zhuwenguan/2025NUEDC_A_Project/README.md

# 2025NUEDC_A_Project

## 简介
本仓库是2025年全国大学生电子竞赛A题——能量回馈的变流器负载试验装置的方案。实现了赛题要求的全部功能，达成了赛题要求的全部指标。

## 构造
1. Hardware文件夹
   包含该项目的所有硬件资料。基于嘉立创EDA设计。
2. Firmware文件夹
   包含该项目的STM32固件源代码。使用STM32CubeMX软件配合Keil MDK-ARM开发。
3. Docs文件夹
   包含该项目的说明文档和博客。

## 方案解析
请参阅[我的博客](https://zhuwenguan.github.io/blog/2025/08/08/25%E7%94%B5%E8%B5%9BA%E9%A2%98%E6%BB%A1%E5%88%86%E6%96%B9%E6%A1%88%E8%A7%A3%E6%9E%90/)
