zhuwenguan/2025NUEDC_A_Project/(list of files, drawings)

Other design files:
1.Hardware/2025NUEDC_A_Project.eprj
