zhuwenguan/2025NUEDC_A_Project/2.Firmware/Core/Src/main.c

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
/* Includes ------------------------------------------------------------------*/
#include "main.h"
#include "adc.h"
#include "dma.h"
#include "ltdc.h"
#include "spi.h"
#include "tim.h"
#include "gpio.h"

/* USER CODE BEGIN Includes */

#include "spwm.h"
#include "volt.h"
#include "curr.h"
#include "ili9341.h"
#include "lcd.h"
#include "stm32f429i_discovery_lcd.h"
#include <string.h>
#include <stdio.h>

/* USER CODE END Includes */


/* USER CODE BEGIN PV */

uint8_t updateFlag;
SPWM_HandleTypeDef hspwm_u, hspwm_v, hspwm_w;
uint16_t volt_buffer[1000];
uint16_t curr_buffer[1000];

uint16_t frameBuffer[240*160];

float rms;
float output = 1.0f;
float target = 32.0f;
float curr_target = 1.0f;
uint32_t freq = 50;
float curr;
float output_curr = 0.15f;

/* USER CODE END PV */

void SystemClock_Config(void);
/* USER CODE BEGIN 0 */

void KeyScan()
{
	static uint32_t lastTime, addTime;
	static uint32_t cnt = 0;
	static uint32_t longPress;
	if(HAL_GetTick() - lastTime >= 10)
	{
		lastTime = HAL_GetTick();
		if(HAL_GPIO_ReadPin(GPIOA, GPIO_PIN_0) == GPIO_PIN_SET)
		{
			if(cnt < 2)
			{
				cnt++;
			}
			if(cnt == 2)
			{
				longPress++;
				if(longPress >= 200)
				{
					if(HAL_GetTick() - addTime >= 100)
					{
						addTime = HAL_GetTick();
						if(freq < 150)
							freq++;
					}
				}
			}
		}
		else
		{
			if(cnt == 2)
			{
				cnt = 3;
				freq++;
				if(freq > 150)
					freq = 20;
			}
			else
			{
				cnt = 0;
				longPress = 0;
			}
		}
	}
}

void LCD_Init()
{
	ili9341_Init();
	BSP_LCD_SetTextColor(0xFFFF);
	BSP_LCD_SetFont(&Font12);
}

void LCD_Refresh()
{
	static uint32_t lastTime;
	if(HAL_GetTick() - lastTime < 200)
		return;
	
	lastTime = HAL_GetTick();
	char str[64];
	snprintf(str, 64, "Volt: %.2f", rms);
	BSP_LCD_DisplayStringAt(0, 0, (uint8_t*)str, LEFT_MODE);
//	snprintf(str, 64, "Current: %.2f", curr);
//	BSP_LCD_DisplayStringAt(0, 14, (uint8_t*)str, LEFT_MODE);
	snprintf(str, 64, "Freq: %d Hz", freq);
	BSP_LCD_DisplayStringAt(0, 14, (uint8_t*)str, LEFT_MODE);
//	snprintf(str, 64, "SPWM Rate: %.2f", output);
//	BSP_LCD_DisplayStringAt(0, 42, (uint8_t*)str, LEFT_MODE);
//	snprintf(str, 64, "BOOST Duty: %.2f", output_curr);
//	BSP_LCD_DisplayStringAt(0, 56, (uint8_t*)str, LEFT_MODE);
}

/* USER CODE END 0 */

/**
  * @brief  The application entry point.
  * @retval int
  */
int main(void)
{

  /* MCU Configuration--------------------------------------------------------*/

  /* Reset of all peripherals, Initializes the Flash interface and the Systick. */
  HAL_Init();

  /* Configure the system clock */
  SystemClock_Config();

  /* Initialize all configured peripherals */
  MX_GPIO_Init();
  MX_DMA_Init();
  MX_TIM1_Init();
  MX_TIM8_Init();
  MX_ADC1_Init();
  MX_TIM2_Init();
  MX_ADC2_Init();
  MX_LTDC_Init();
  MX_SPI5_Init();
  /* USER CODE BEGIN 2 */
  SPWM_Init(&hspwm_u, PWM_MAX, freq, 0.0f);
  SPWM_Init(&hspwm_v, PWM_MAX, freq, 0.3333333f);
  SPWM_Init(&hspwm_w, PWM_MAX, freq, 0.6666666f);
  
  HAL_TIM_Base_Start(&htim8);
  __HAL_TIM_SetCompare(&htim8, TIM_CHANNEL_3, TIM8->ARR+1);
  HAL_TIM_PWM_Start(&htim8, TIM_CHANNEL_3);
  
  HAL_TIM_Base_Start(&htim1);
  HAL_TIM_PWM_Start_DMA(&htim1, TIM_CHANNEL_1, (uint32_t*)hspwm_u.array, hspwm_u.size);
  HAL_TIM_PWM_Start_DMA(&htim1, TIM_CHANNEL_2, (uint32_t*)hspwm_v.array, hspwm_v.size);
  HAL_TIM_PWM_Start_DMA(&htim1, TIM_CHANNEL_3, (uint32_t*)hspwm_w.array, hspwm_w.size);
  
  HAL_TIM_Base_Start(&htim2);
  HAL_ADC_Start_DMA(&hadc1, (uint32_t*)volt_buffer, 1000);
  HAL_ADC_Start_DMA(&hadc2, (uint32_t*)curr_buffer, 1000);
  
  LCD_Init();
  VOLT_Init();
  CURR_Init();
  /* USER CODE END 2 */

  /* Infinite loop */
  /* USER CODE BEGIN WHILE */
  while (1)
  {
    /* USER CODE END WHILE */

    /* USER CODE BEGIN 3 */
	  VOLT_Update();
	  CURR_Update();
	  SPWM_Update();
	  LCD_Refresh();
	  KeyScan();
  }
  /* USER CODE END 3 */
}

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
