zhuwenguan/2025NUEDC_A_Project/2.Firmware/2025NUEDC_A_Project.ioc

Mcu.UserName=STM32F429ZITx
PA0/WKUP.Signal=GPIO_Input
PA11.Signal=LTDC_R4
PA12.Signal=LTDC_R5
PA13.Signal=SYS_JTMS-SWDIO
PA14.Signal=SYS_JTCK-SWCLK
PA3.Signal=LTDC_B5
PA4.Signal=LTDC_VSYNC
PA6.Signal=LTDC_G2
PB0.Signal=LTDC_R3
PB1.Signal=LTDC_R6
PB10.Signal=LTDC_G4
PB11.Signal=LTDC_G5
PB12.Signal=GPIO_Output
PB8.Signal=LTDC_B6
PB9.Signal=LTDC_B7
PC2.GPIO_Label=LCD_NCS
PC2.Signal=GPIO_Output
PC4.Signal=ADCx_IN14
PC5.Signal=ADCx_IN15
PC6.Signal=LTDC_HSYNC
PC7.Signal=LTDC_G6
PC8.Signal=S_TIM8_CH3
PD12.GPIO_Label=LCD_RDX
PD12.Signal=GPIO_Output
PD13.GPIO_Label=LCD_WRX
PD13.Signal=GPIO_Output
PD3.Signal=LTDC_G7
PE11.Signal=S_TIM1_CH2
PE13.Signal=S_TIM1_CH3
PE15.Signal=GPIO_Output
PE9.Signal=S_TIM1_CH1
PF10.Signal=LTDC_DE
PF7.Signal=SPI5_SCK
PF8.Signal=SPI5_MISO
PF9.Signal=SPI5_MOSI
PG10.Signal=LTDC_G3
PG11.Signal=LTDC_B3
PG12.Signal=LTDC_B4
PG5.Signal=GPIO_Output
PG6.Signal=LTDC_R7
PG7.Signal=LTDC_CLK
PH0/OSC_IN.Signal=RCC_OSC_IN
PH1/OSC_OUT.Signal=RCC_OSC_OUT
