zhuwenguan/2025NUEDC_A_Project/2.Firmware/Core/Inc/main.h

#define PWM_FREQ (80000)
#define PWM_MAX (2250-1)
#define LCD_NCS_Pin GPIO_PIN_2
#define LCD_NCS_GPIO_Port GPIOC
#define LCD_RDX_Pin GPIO_PIN_12
#define LCD_RDX_GPIO_Port GPIOD
#define LCD_WRX_Pin GPIO_PIN_13
#define LCD_WRX_GPIO_Port GPIOD
