zhuwenguan/2025NUEDC_A_Project/2.Firmware/Core/Src/ili9341.c

/**
  ******************************************************************************
  * @file    ili9341.c
  * @author  MCD Application Team
  * @version V1.0.2
  * @date    02-December-2014
  * @brief   This file includes the LCD driver for ILI9341 LCD.
  ******************************************************************************
  * @attention
  *
  * Copyright (c) 2014 STMicroelectronics.
  * All rights reserved.
  *
  * This software is licensed under terms that can be found in the LICENSE file
  * in the root directory of this software component.
  * If no LICENSE file comes with this software, it is provided AS-IS.
  *
  ******************************************************************************
  */ 

/* Includes ------------------------------------------------------------------*/
#include "ili9341.h"
#include "main.h"
#include "spi.h"
/** @addtogroup BSP
  * @{
  */ 

/** @addtogroup Components
  * @{
  */ 
  
/** @addtogroup ILI9341
  * @brief This file provides a set of functions needed to drive the 
  *        ILI9341 LCD.
  * @{
  */

/** @defgroup ILI9341_Private_TypesDefinitions
  * @{
  */ 
/**
  * @}
  */ 

/** @defgroup ILI9341_Private_Defines
  * @{
  */
/**
  * @}
  */ 
  
/** @defgroup ILI9341_Private_Macros
  * @{
  */
/**
  * @}
  */  

/** @defgroup ILI9341_Private_Variables
  * @{
  */ 

LCD_DrvTypeDef   ili9341_drv = 
{
  ili9341_Init,
  ili9341_ReadID,
  ili9341_DisplayOn,
  ili9341_DisplayOff,
  0,
  0,
  0,
  0,
  0,
  0,
  ili9341_GetLcdPixelWidth,
  ili9341_GetLcdPixelHeight,
  0,
  0,    
};

/**
  * @}
  */ 
  
/** @defgroup ILI9341_Private_FunctionPrototypes
  * @{
  */

/**
  * @}
  */ 
  
/** @defgroup ILI9341_Private_Functions
  * @{
  */   

/* Chip Select macro definition */
#define LCD_CS_LOW()       HAL_GPIO_WritePin(LCD_NCS_GPIO_PORT, LCD_NCS_PIN, GPIO_PIN_RESET)
#define LCD_CS_HIGH()      HAL_GPIO_WritePin(LCD_NCS_GPIO_PORT, LCD_NCS_PIN, GPIO_PIN_SET)

/* Set WRX High to send data */
#define LCD_WRX_LOW()      HAL_GPIO_WritePin(LCD_WRX_GPIO_PORT, LCD_WRX_PIN, GPIO_PIN_RESET)
#define LCD_WRX_HIGH()     HAL_GPIO_WritePin(LCD_WRX_GPIO_PORT, LCD_WRX_PIN, GPIO_PIN_SET)

/* Set WRX High to send data */
#define LCD_RDX_LOW()      HAL_GPIO_WritePin(LCD_RDX_GPIO_PORT, LCD_RDX_PIN, GPIO_PIN_RESET)
#define LCD_RDX_HIGH()     HAL_GPIO_WritePin(LCD_RDX_GPIO_PORT, LCD_RDX_PIN, GPIO_PIN_SET)

/**
  * @brief  LCD Control pin
  */
#define LCD_NCS_PIN                             GPIO_PIN_2
#define LCD_NCS_GPIO_PORT                       GPIOC
#define LCD_NCS_GPIO_CLK_ENABLE()               __HAL_RCC_GPIOC_CLK_ENABLE()
#define LCD_NCS_GPIO_CLK_DISABLE()              __HAL_RCC_GPIOC_CLK_DISABLE()
/**
  * @}
  */
/**
  * @brief  LCD Command/data pin
  */
#define LCD_WRX_PIN                             GPIO_PIN_13
#define LCD_WRX_GPIO_PORT                       GPIOD
#define LCD_WRX_GPIO_CLK_ENABLE()               __HAL_RCC_GPIOD_CLK_ENABLE()
#define LCD_WRX_GPIO_CLK_DISABLE()              __HAL_RCC_GPIOD_CLK_DISABLE()

#define LCD_RDX_PIN                             GPIO_PIN_12
#define LCD_RDX_GPIO_PORT                       GPIOD
#define LCD_RDX_GPIO_CLK_ENABLE()               __HAL_RCC_GPIOD_CLK_ENABLE()
#define LCD_RDX_GPIO_CLK_DISABLE()              __HAL_RCC_GPIOD_CLK_DISABLE()

/**
  * @brief  Reads 4 bytes from device.
  * @param  ReadSize: Number of bytes to read (max 4 bytes)
  * @retval Value read on the SPI
  */
static uint32_t SPIx_Read(uint8_t ReadSize)
{
  HAL_StatusTypeDef status = HAL_OK;
  uint32_t readvalue;

  status = HAL_SPI_Receive(&hspi5, (uint8_t *) &readvalue, ReadSize, 0x1000);

  /* Check the communication status */
  if (status != HAL_OK)
  {
    /* Re-Initialize the BUS */
    Error_Handler();
  }

  return readvalue;
}

/**
  * @brief  Writes a byte to device.
  * @param  Value: value to be written
  */
static void SPIx_Write(uint16_t Value)
{
  HAL_StatusTypeDef status = HAL_OK;

  status = HAL_SPI_Transmit(&hspi5, (uint8_t *) &Value, 1, 0x1000);

  /* Check the communication status */
  if (status != HAL_OK)
  {
    /* Re-Initialize the BUS */
    Error_Handler();
  }
}

/**
  * @brief  Writes register value.
  */
void LCD_IO_WriteData(uint16_t RegValue)
{
  /* Set WRX to send data */
  LCD_WRX_HIGH();

  /* Reset LCD control line(/CS) and Send data */
  LCD_CS_LOW();
  SPIx_Write(RegValue);

  /* Deselect: Chip Select high */
  LCD_CS_HIGH();
}

/**
  * @brief  Writes register address.
  */
void LCD_IO_WriteReg(uint8_t Reg)
{
  /* Reset WRX to send command */
  LCD_WRX_LOW();

  /* Reset LCD control line(/CS) and Send command */
  LCD_CS_LOW();
  SPIx_Write(Reg);

  /* Deselect: Chip Select high */
  LCD_CS_HIGH();
}

/**
  * @brief  Reads register value.
  * @param  RegValue Address of the register to read
  * @param  ReadSize Number of bytes to read
  * @retval Content of the register value
  */
uint32_t LCD_IO_ReadData(uint16_t RegValue, uint8_t ReadSize)
{
  uint32_t readvalue = 0;

  /* Select: Chip Select low */
  LCD_CS_LOW();

  /* Reset WRX to send command */
  LCD_WRX_LOW();

  SPIx_Write(RegValue);

  readvalue = SPIx_Read(ReadSize);

  /* Set WRX to send data */
  LCD_WRX_HIGH();

  /* Deselect: Chip Select high */
  LCD_CS_HIGH();

  return readvalue;
}

/**
  * @brief  Wait for loop in ms.
  * @param  Delay in ms.
  */
void LCD_Delay(uint32_t Delay)
{
  HAL_Delay(Delay);
}

/**
  * @brief  Configures the LCD_SPI interface.
  */
void LCD_IO_Init(void)
{
//  GPIO_InitTypeDef GPIO_InitStructure;

//    /* Configure NCS in Output Push-Pull mode */
//    LCD_WRX_GPIO_CLK_ENABLE();
//    GPIO_InitStructure.Pin     = LCD_WRX_PIN;
//    GPIO_InitStructure.Mode    = GPIO_MODE_OUTPUT_PP;
//    GPIO_InitStructure.Pull    = GPIO_NOPULL;
//    GPIO_InitStructure.Speed   = GPIO_SPEED_FAST;
//    HAL_GPIO_Init(LCD_WRX_GPIO_PORT, &GPIO_InitStructure);

//    LCD_RDX_GPIO_CLK_ENABLE();
//    GPIO_InitStructure.Pin     = LCD_RDX_PIN;
//    GPIO_InitStructure.Mode    = GPIO_MODE_OUTPUT_PP;
//    GPIO_InitStructure.Pull    = GPIO_NOPULL;
//    GPIO_InitStructure.Speed   = GPIO_SPEED_FAST;
//    HAL_GPIO_Init(LCD_RDX_GPIO_PORT, &GPIO_InitStructure);

//    /* Configure the LCD Control pins ----------------------------------------*/
//    LCD_NCS_GPIO_CLK_ENABLE();

//    /* Configure NCS in Output Push-Pull mode */
//    GPIO_InitStructure.Pin     = LCD_NCS_PIN;
//    GPIO_InitStructure.Mode    = GPIO_MODE_OUTPUT_PP;
//    GPIO_InitStructure.Pull    = GPIO_NOPULL;
//    GPIO_InitStructure.Speed   = GPIO_SPEED_FAST;
//    HAL_GPIO_Init(LCD_NCS_GPIO_PORT, &GPIO_InitStructure);

    /* Set or Reset the control line */
    LCD_CS_LOW();
    LCD_CS_HIGH();
}



/**
  * @brief  Power on the LCD.
  * @param  None
  * @retval None
  */
void ili9341_Init(void)
{
  /* Initialize ILI9341 low level bus layer ----------------------------------*/
  LCD_IO_Init();
  
  /* Configure LCD */
  ili9341_WriteReg(0xCA);
  ili9341_WriteData(0xC3);
  ili9341_WriteData(0x08);
  ili9341_WriteData(0x50);
  ili9341_WriteReg(LCD_POWERB);
  ili9341_WriteData(0x00);
  ili9341_WriteData(0xC1);
  ili9341_WriteData(0x30);
  ili9341_WriteReg(LCD_POWER_SEQ);
  ili9341_WriteData(0x64);
  ili9341_WriteData(0x03);
  ili9341_WriteData(0x12);
  ili9341_WriteData(0x81);
  ili9341_WriteReg(LCD_DTCA);
  ili9341_WriteData(0x85);
  ili9341_WriteData(0x00);
  ili9341_WriteData(0x78);
  ili9341_WriteReg(LCD_POWERA);
  ili9341_WriteData(0x39);
  ili9341_WriteData(0x2C);
  ili9341_WriteData(0x00);
  ili9341_WriteData(0x34);
  ili9341_WriteData(0x02);
  ili9341_WriteReg(LCD_PRC);
  ili9341_WriteData(0x20);
  ili9341_WriteReg(LCD_DTCB);
  ili9341_WriteData(0x00);
  ili9341_WriteData(0x00);
  ili9341_WriteReg(LCD_FRMCTR1);
  ili9341_WriteData(0x00);
  ili9341_WriteData(0x1B);
  ili9341_WriteReg(LCD_DFC);
  ili9341_WriteData(0x0A);
  ili9341_WriteData(0xA2);
  ili9341_WriteReg(LCD_POWER1);
  ili9341_WriteData(0x10);
  ili9341_WriteReg(LCD_POWER2);
  ili9341_WriteData(0x10);
  ili9341_WriteReg(LCD_VCOM1);
  ili9341_WriteData(0x45);
  ili9341_WriteData(0x15);
  ili9341_WriteReg(LCD_VCOM2);
  ili9341_WriteData(0x90);
  ili9341_WriteReg(LCD_MAC);
  ili9341_WriteData(0xC8);
  ili9341_WriteReg(LCD_3GAMMA_EN);
  ili9341_WriteData(0x00);
  ili9341_WriteReg(LCD_RGB_INTERFACE);
  ili9341_WriteData(0xC2);
  ili9341_WriteReg(LCD_DFC);
  ili9341_WriteData(0x0A);
  ili9341_WriteData(0xA7);
  ili9341_WriteData(0x27);
  ili9341_WriteData(0x04);
  
  /* Colomn address set */
  ili9341_WriteReg(LCD_COLUMN_ADDR);
  ili9341_WriteData(0x00);
  ili9341_WriteData(0x00);
  ili9341_WriteData(0x00);
  ili9341_WriteData(0xEF);
  /* Page address set */
  ili9341_WriteReg(LCD_PAGE_ADDR);
  ili9341_WriteData(0x00);
  ili9341_WriteData(0x00);
  ili9341_WriteData(0x01);
  ili9341_WriteData(0x3F);
  ili9341_WriteReg(LCD_INTERFACE);
  ili9341_WriteData(0x01);
  ili9341_WriteData(0x00);
  ili9341_WriteData(0x06);
  
  ili9341_WriteReg(LCD_GRAM);
  LCD_Delay(200);
  
  ili9341_WriteReg(LCD_GAMMA);
  ili9341_WriteData(0x01);
  
  ili9341_WriteReg(LCD_PGAMMA);
  ili9341_WriteData(0x0F);
  ili9341_WriteData(0x29);
  ili9341_WriteData(0x24);
  ili9341_WriteData(0x0C);
  ili9341_WriteData(0x0E);
  ili9341_WriteData(0x09);
  ili9341_WriteData(0x4E);
  ili9341_WriteData(0x78);
  ili9341_WriteData(0x3C);
  ili9341_WriteData(0x09);
  ili9341_WriteData(0x13);
  ili9341_WriteData(0x05);
  ili9341_WriteData(0x17);
  ili9341_WriteData(0x11);
  ili9341_WriteData(0x00);
  ili9341_WriteReg(LCD_NGAMMA);
  ili9341_WriteData(0x00);
  ili9341_WriteData(0x16);
  ili9341_WriteData(0x1B);
  ili9341_WriteData(0x04);
  ili9341_WriteData(0x11);
  ili9341_WriteData(0x07);
  ili9341_WriteData(0x31);
  ili9341_WriteData(0x33);
  ili9341_WriteData(0x42);
  ili9341_WriteData(0x05);
  ili9341_WriteData(0x0C);
  ili9341_WriteData(0x0A);
  ili9341_WriteData(0x28);
  ili9341_WriteData(0x2F);
  ili9341_WriteData(0x0F);
  
  ili9341_WriteReg(LCD_SLEEP_OUT);
  LCD_Delay(200);
  ili9341_WriteReg(LCD_DISPLAY_ON);
  /* GRAM start writing */
  ili9341_WriteReg(LCD_GRAM);
}

/**
  * @brief  Disables the Display.
  * @param  None
  * @retval LCD Register Value.
  */
uint16_t ili9341_ReadID(void)
{
  LCD_IO_Init();
  return ((uint16_t)ili9341_ReadData(LCD_READ_ID4, LCD_READ_ID4_SIZE));
}

/**
  * @brief  Enables the Display.
  * @param  None
  * @retval None
  */
void ili9341_DisplayOn(void)
{
  /* Display On */
  ili9341_WriteReg(LCD_DISPLAY_ON);
}

/**
  * @brief  Disables the Display.
  * @param  None
  * @retval None
  */
void ili9341_DisplayOff(void)
{
  /* Display Off */
  ili9341_WriteReg(LCD_DISPLAY_OFF);
}

/**
  * @brief  Writes  to the selected LCD register.
  * @param  LCD_Reg: address of the selected register.
  * @retval None
  */
void ili9341_WriteReg(uint8_t LCD_Reg)
{
  LCD_IO_WriteReg(LCD_Reg);
}

/**
  * @brief  Writes data to the selected LCD register.
  * @param  LCD_Reg: address of the selected register.
  * @retval None
  */
void ili9341_WriteData(uint16_t RegValue)
{
  LCD_IO_WriteData(RegValue);
}

/**
  * @brief  Reads the selected LCD Register.
  * @param  RegValue: Address of the register to read
  * @param  ReadSize: Number of bytes to read
  * @retval LCD Register Value.
  */
uint32_t ili9341_ReadData(uint16_t RegValue, uint8_t ReadSize)
{
  /* Read a max of 4 bytes */
  return (LCD_IO_ReadData(RegValue, ReadSize));
}

/**
  * @brief  Get LCD PIXEL WIDTH.
  * @param  None
  * @retval LCD PIXEL WIDTH.
  */
uint16_t ili9341_GetLcdPixelWidth(void)
{
  /* Return LCD PIXEL WIDTH */
  return ILI9341_LCD_PIXEL_WIDTH;
}

/**
  * @brief  Get LCD PIXEL HEIGHT.
  * @param  None
  * @retval LCD PIXEL HEIGHT.
  */
uint16_t ili9341_GetLcdPixelHeight(void)
{
  /* Return LCD PIXEL HEIGHT */
  return ILI9341_LCD_PIXEL_HEIGHT;
}

/**
  * @}
  */ 

/**
  * @}
  */ 
  
/**
  * @}
  */ 

/**
  * @}
  */
