zhuwenguan/2025NUEDC_A_Project/(notices)

Notices in the files:
2.Firmware/Core/Src/main.c:
Copyright (c) 2025 STMicroelectronics.
All rights reserved.
